Pronio/Arcade-Machine/rtl/PS2/src/paddleController.v

`timescale 1ns / 1ps

module paddleController
  // Parameter dimensions to set paddles motion are in pixels
  #(parameter PLAYER1_UP_KEY = 8'h1D, // W key as default
  parameter PLAYER1_DOWN_KEY = 8'h1B, // S key as default
  parameter PLAYER2_UP_KEY = 8'h44, // O key as default
  parameter PLAYER2_DOWN_KEY = 8'h4B, // L key as default
  parameter SCREEN_HEIGHT = 480, // Total screen height, in pixels
  parameter PADDLE_LENGTH = 40,    // Total length of each one of the paddles
  parameter START_POS = (SCREEN_HEIGHT - PADDLE_LENGTH)/2, //Starting position of the paddles
  parameter FRAME_WIDTH = 10,      // Size of the border
  parameter MOTION_STEP = 10,      // How many pixels the paddle move each time
  parameter BOTTOM_POS = SCREEN_HEIGHT - (PADDLE_LENGTH + FRAME_WIDTH), // Bottom limit to where paddle can go
  parameter COUNT = 12500000) ( // Value used in a counter, in order to create a signal, default is every 250ms
                            // in a certain time in order to increase/decrease
                            // paddle positions
  input clk,             // Input clock, 50MHz
  input rst,             // Reset signal
  input ps2Clk,          // PS/2 input clock, 10-16.7MHz
  input ps2Data,         // PS/2 data
  output reg [clog2(BOTTOM_POS)-1 : 0] paddle1, // Position in each the Paddle 1 is
  output reg [clog2(BOTTOM_POS)-1 : 0] paddle2  // Position in each the Paddle 2 is
  );

  //Solution from https://www.xilinx.com/support/answers/44586.html for clog2
  function integer clog2;
    input integer value;
    begin
      value = value-1;
      for (clog2=0; value>0; clog2=clog2+1)
        value = value>>1;
    end
  endfunction

  reg [clog2(COUNT) : 0] counter = 0;
  //reg [16 : 0] resetCounter = 0;
  //Problem while testing...seems that 16 is not enough
  reg [17 : 0] resetCounter = 0;
  reg breakCode = 0;
  reg incPaddle1 = 0, decPaddle1 = 0; // Incremente or decrease Paddle 1 position
  reg incPaddle2 = 0, decPaddle2 = 0; // Incremente or decrease Paddle 2 position
  reg readEn = 0;
  reg lastValid = 0;
  wire [7 : 0] code;
  wire valid;

  wire [7:0] BREAK_CODE = 8'hF0; // Break code

  PS2 keyboard (
    .clk(clk),
    .rst(rst),
    .ps2Clk(ps2Clk),
    .ps2Data(ps2Data),
    .code(code),
    .valid(valid)
  );

  // Create signal every clk/COUNT in order to increment/decrement paddle positions
  always @(posedge clk) begin
    if(rst)   // Reset to default values
      counter <= 0;
    else if(counter == COUNT)
      counter <= 0;
    else
      counter <= counter + 1;
  end

  // Reset counter for when a break code is recieved but if in a given time
  // the rest of the code is not received, reset breakCode
  // A new key takes up to 1.1ms to be recieved
  always @(posedge clk) begin
    if(rst)   // Reset to default values
      resetCounter <= 0;
    //else if(resetCounter[16] || !breakCode)
    //Problem while testing...seems that 16 is not enough
    else if(resetCounter[17] || !breakCode)
      resetCounter <= 0;
    else begin
      if(breakCode)
        resetCounter <= resetCounter + 1;
    end
  end

  //check if a new code has been outputted by the PS2 module
  always @(posedge clk) begin
    if(rst) begin   // Reset to default value
      breakCode <= 0;
      incPaddle1 <= 0;
      decPaddle1 <= 0;
      incPaddle2 <= 0;
      incPaddle2 <= 0;
    //end else if(resetCounter[16])
    //Problem while testing...seems that 16 is not enough
    end else if(resetCounter[17])
      breakCode <= 0;
    else if(readEn) begin
      if(code == BREAK_CODE)
        breakCode <= 1;
      else if(code == PLAYER1_DOWN_KEY) begin
        if(breakCode) begin
          breakCode <= 0;
          incPaddle1 <= 0;
        end else
          incPaddle1 <= 1;
      end else if(code == PLAYER1_UP_KEY) begin
        if(breakCode) begin
          breakCode <= 0;
          decPaddle1 <= 0;
        end else
          decPaddle1 <= 1;
      end else if(code == PLAYER2_DOWN_KEY) begin
        if(breakCode) begin
          breakCode <= 0;
          incPaddle2 <= 0;
        end else
          incPaddle2 <= 1;
      end else if(code == PLAYER2_UP_KEY) begin
        if(breakCode) begin
          breakCode <= 0;
          decPaddle2 <= 0;
        end else
          decPaddle2 <= 1;
      end
    end
  end

  // Increment/Decrease Paddle 1 position depending on the keys that are pressed
  always @(posedge clk) begin
    if(rst) begin   // Reset to default values
      paddle1 <= START_POS;
    end else if(counter == COUNT) begin
      if(incPaddle1 && !decPaddle1) begin
        if(paddle1 + MOTION_STEP <= BOTTOM_POS)
          paddle1 <= paddle1 + MOTION_STEP;
      end else if(decPaddle1 && !incPaddle1) begin
        if(paddle1 - MOTION_STEP >= FRAME_WIDTH)
          paddle1 <= paddle1 - MOTION_STEP;
      end
    end
  end

  // Increment/Decrease Paddle 2 position depending on the keys that are pressed
  always @(posedge clk) begin
    if(rst) begin   // Reset to default values
      paddle2 <= START_POS;
    end else if(counter == COUNT) begin
      if(incPaddle2 && !decPaddle2) begin
        if(paddle2 + MOTION_STEP <= BOTTOM_POS)
          paddle2 <= paddle2 + MOTION_STEP;
      end else if(decPaddle2 && !incPaddle2) begin
        if(paddle2 - MOTION_STEP >= FRAME_WIDTH)
          paddle2 <= paddle2 - MOTION_STEP;
      end
    end
  end

  always @(posedge clk) begin
    if(rst) begin
      readEn <= 0;
      lastValid <= 0;
    end else if(valid && !lastValid) begin
      readEn <= 1;
      lastValid <= 1;
    end else if(valid && lastValid)
      readEn <= 0;
    else if(!valid && lastValid)
      lastValid <= 0;

  end

  endmodule
