Pronio/Arcade-Machine/rtl/vgadisplay/object_detection_tb.v

`timescale 1ns / 1ps

module object_detection_tb;
   
   reg [8:0] 	 x_pos;
   reg [9:0] 	 y_pos;
   reg  [8:0]	 Px;
   reg  [9:0]	 Py;
   reg  [9:0]	 W;
   reg  [8:0]	 H;
   wire		 detected; 

   // Instantiate the Unit Under Test (UUT)
   object_detection uut (
		.x_pos(x_pos),
		.y_pos(y_pos),
		.Px(Px),
		.Py(Py),
		.W(W),
		.H(H),
                .detected(detected)
		);
 
   
   initial begin
      $dumpfile("object_detection.vcd");
      $dumpvars();
      
      y_pos = 0;
      x_pos = 0;
      Px = 10;
      Py = 10;
      W = 10;
      H = 10;
    
      #10000000	 
      $finish;

   end

   always #10 begin
      if((x_pos<479)&&(y_pos==639))
         x_pos = x_pos+1;
      else if(y_pos==639)
         x_pos = 0;

      if(y_pos<639)
         y_pos = y_pos+1;
      else
         y_pos = 0;
   end
	

endmodule
