Pronio/Arcade-Machine/(commit log)

2019-11-20 assembly code for test program of ps2
2019-12-02 Assemble the peripherals (vgadisplay & ps2Controller) with picoversat, and testing made sucessfully. Assembly code for the paddles movement already made
2019-12-04 added function for clog2 because xilinx ise 14.7 is stupid and doesn't have it
    [paddleController.v]
2019-12-04 corrected problem during simulation...it seems that the counter with 1.1ms was not enough
    [paddleController.v, paddleController_tb.v]
2019-12-04 Fixes to run on ISE xilinx
    [vgadisplay.v, xtop.v]
2019-12-04 corrected error with push
    [vgadisplay.v]
2019-12-16 Development of assembly program for pong game & minor fixes on vgacontroller
    [vgacontroller.v]
2019-12-16 Add start register and conclude assembly code
2019-12-18 Minor fixes and adjustments, reset game when reaching a score of 99
    [7SegDisplay.v, xtop.v]
2020-01-27 User Manual and testbench corrections
    [xtop_tb.v]
